rishachakraborty/Programmable-Apparatus-for-Variable-Liquid-Intake-Quantification-PAVLIQ/MouseTask Electronics Diagram V1_bb.png

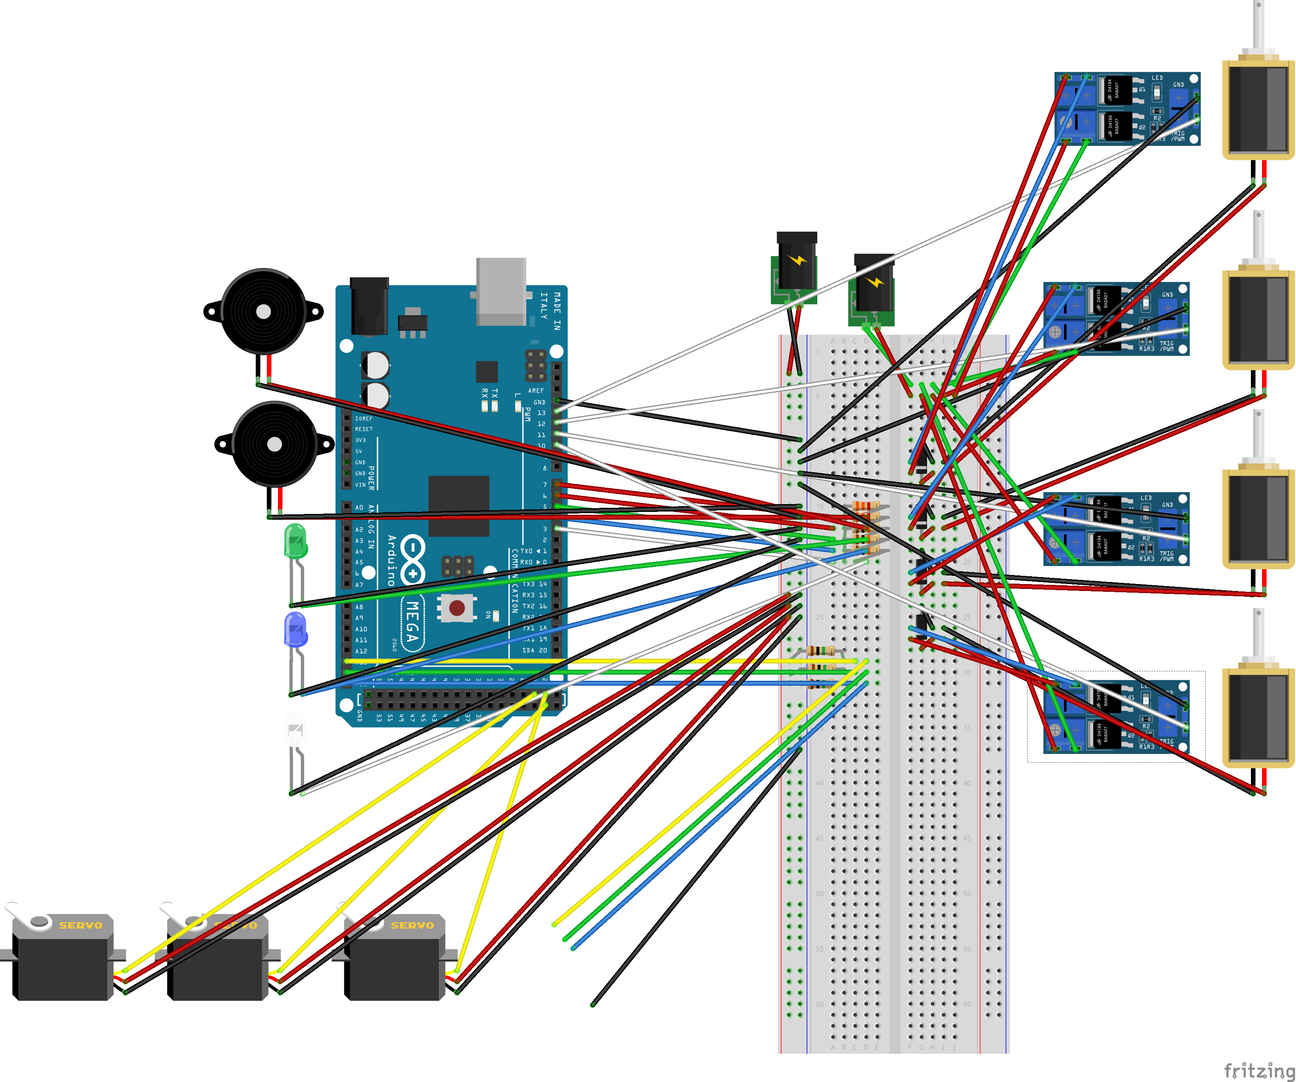
MouseTask Electronics Diagram V1_bb.png
