rishachakraborty/Programmable-Apparatus-for-Variable-Liquid-Intake-Quantification-PAVLIQ/gui_cue.py

"""
gui_cue.py — full-parameter editor for a cue set.

A cue set is any combination of auditory, visual, olfactory and
user-defined stimuli presented together. This module provides one editor
that exposes every parameter of every modality, and both trial cues and
block-transition cues use it. Because there is a single implementation,
the parameters available in one context are always identical to those
available in the other.

All enabled modalities within a set are hardware-triggered from a single
staged batch, so they share one onset timestamp rather than being issued
sequentially.
"""

from __future__ import annotations

from typing import Optional

from PyQt6.QtCore import Qt
from PyQt6.QtGui import QFont
from PyQt6.QtWidgets import (
    QCheckBox, QComboBox, QDialog, QDialogButtonBox, QDoubleSpinBox,
    QFormLayout, QGroupBox, QHBoxLayout, QLabel, QLineEdit, QPushButton,
    QSpinBox, QVBoxLayout, QWidget,
)

from task_design import CueSet, LedCue, OlfactoryCue, OtherCue, SpeakerCue

LED_CHANNELS = [("w", "White"), ("b", "Blue"), ("g", "Green")]


def _mono(sz=9) -> QFont:
    f = QFont("Menlo", sz)
    f.setStyleHint(QFont.StyleHint.Monospace)
    return f


class SpeakerCueEditor(QGroupBox):
    """Auditory stimulus parameters."""

    def __init__(self):
        super().__init__("Auditory stimulus")
        self.setCheckable(True)
        f = QFormLayout(self)

        self.duration = QSpinBox()
        self.duration.setRange(1, 60000)
        self.duration.setValue(500)
        self.duration.setSuffix(" ms")

        self.tone_hz = QSpinBox()
        self.tone_hz.setRange(20, 40000)
        self.tone_hz.setSingleStep(500)
        self.tone_hz.setValue(10000)
        self.tone_hz.setSuffix(" Hz")

        self.click_train = QCheckBox("Amplitude-modulate the carrier "
                                     "(click train)")
        self.click_train.setChecked(True)

        self.click_hz = QSpinBox()
        self.click_hz.setRange(1, 1000)
        self.click_hz.setValue(50)
        self.click_hz.setSuffix(" Hz")

        self.loudness = QSpinBox()
        self.loudness.setRange(0, 50)
        self.loudness.setValue(50)
        self.loudness.setSuffix(" % duty")
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
